UnconventionalComputingUWE/PhyChip/Bill of Materials and Pin Map.xls

Sheet: Bill of Materials
Phychip Breakout Board
Part | Value | Device | Package | Description | Manufacturer | MPN | OC_RS
C1 | 10uF | Capacitor POL, | 153CLV 0505 | POLARIZED CAPACITOR, European symbol
C2 | 10uF | Capacitor POL, | 153CLV 0505 | POLARIZED CAPACITOR, European symbol
C3 | 10uF | Capacitor POL, | 153CLV 0505 | POLARIZED CAPACITOR, European symbol
IC1 | DG406CWI | DG406CWI | SO28L | ANALOG MULTIPLEXER | MAXIM | DG406CWI | 797-9247
IC2 | DG406CWI | DG406CWI | SO28L | ANALOG MULTIPLEXER | MAXIM | DG406CWI | 797-9247
JP1 |  | Header | 1X08 | 8 Way 1 Row Socket. 2.54mm pitch |  |  | 681-2997
JP2 |  | Header | 1X08 | 8 Way 1 Row Socket. 2.54mm pitch |  |  | 681-2997
JP3 |  | Header | 1X10 | 10 Way 1 Row Socket. 2.54mm pitch
JP4 |  | Header | 1X10 | 10 Way 1 Row Socket. 2.54mm pitch
JP5 |  | Header | 1X08 | 4 Way 1 Row Header. 2.54mm pitch
JP6 |  | Header | 1X08 | 5 Way 1 Row Header. 2.54mm pitch
JP7 |  | Header | 1X08 | 6 Way 1 Row Header. 2.54mm pitch
JP8 |  | Header | 1X08 | 7 Way 1 Row Header. 2.54mm pitch
JP9 |  | Header | 1X08 | 8 Way 1 Row Header. 2.54mm pitch
JP10 |  | Header | 1X10 | 10 Way 1 Row Header. 2.54mm pitch
JP11 |  | Header | 2X18 | 36 Way 2 Row Straight Pin Header. 2.54mm pitch
U1 | LTC2440CGNPBF | LTC2440CGNPBF | SOP63P600X175-16N | ADC | Linear Technology | LTC2440CGN#PBF | 1651798
U2 | ADM660ARZ | ADM660ARZ | SOIC127P600X175-8N | CMOS Switched-Capacitor Voltage Converters | Analog Devices | ADM660ARZ | 1661070
Phychip MEA Plugin
Part | Value | Device | Package | Description
JP1 |  | Header | 1X08 | 4 Way 1 Row Header. 2.54mm pitch
JP2 |  | Header | 1X08 | 4 Way 1 Row Header. 2.54mm pitch
JP3 |  | Header | 1X10 | 10 Way 1 Row Header. 2.54mm pitch
JP4 |  | Header | 1X10 | 10 Way 1 Row Header. 2.54mm pitch
JP5 (optional) |  | Header | 1X10 | 10 Way 1 Row Header. 2.54mm pitch
JP6 (optional) |  | Header | 1X10 | 10 Way 1 Row Header. 2.54mm pitch

Sheet: Pin Map
Phychip Breakout Board |  |  |  | Phychip MEA Board
U1
Arduino |  | Phychip |  | Arduino | JP3 | JP4 | JP4 | JP5 | JP7
Pin | Function | Pin | Function | V+ | 1 | 1 | 1 | 1 | 1
D52 | sck | 13 | SCK | 2 | 2 | 2 | 2 | 2 | 2
D53 |  | 11 | ~CS | 3 | 3 | 3 | 3 | 3 | 3
D51 | mosi | 7 | SDI | 4 | 4 | 4 | 4 | 4 | 4
D50 | miso | 12 | SDO | 5 | 5 | 5 | 5 | 5 | 5
D49 |  | 15 | BUSY | 6 | 6 | 6 | 6 | 6 | 6
 |  |  |  | 7 | 7 | 7 | 7 | 7 | 7
IC1 |  |  |  | 8 | 8 | 8 | 8 | 8 | 8
Arduino |  | Phychip |  | 9 | 9 | 9 | 9 | 9 | 9
Pin | Function | Pin | Function | GND | 10 | 10 | 10 | 10 | 10
D29 |  | 17 | A0
D31 |  | 16 | A1
D33 |  | 15 | A2
D35 |  | 14 | A3 | IC1 & IC2 to MEA Pins |  |  |  | MUX control |  | Taken from DG406 Datasheet
D37 |  | 18 | EN
 |  |  |  | MUX Pin | MEA (X,Y) |  |  | A3 | A2 | A1 | A0 | En | On Switch
IC2 |  |  |  | S1 | 1,1 |  |  | X | X | X | X | 0 | None
Arduino |  | Phychip |  | S2 | 1,2 |  |  | 0 | 0 | 0 | 0 | 1 | 1
Pin | Function | Pin | Function | S3 | 3,1 |  |  | 0 | 0 | 0 | 1 | 1 | 2
D39 |  | 17 | A0 | S4 | 4,1 |  |  | 0 | 0 | 1 | 0 | 1 | 3
D41 |  | 16 | A1 | S5 | 2,1 |  |  | 0 | 0 | 1 | 1 | 1 | 4
D43 |  | 15 | A2 | S6 | 2,2 |  |  | 0 | 1 | 0 | 0 | 1 | 5
D45 |  | 14 | A3 | S7 | 3,2 |  |  | 0 | 1 | 0 | 1 | 1 | 6
D47 |  | 18 | EN | S8 | 4,2 |  |  | 0 | 1 | 1 | 0 | 1 | 7
 |  |  |  | S9 | 4,4 |  |  | 0 | 1 | 1 | 1 | 1 | 8
JP3 |  |  |  | S10 | 3,4 |  |  | 1 | 0 | 0 | 0 | 1 | 9
Arduino |  | Phychip |  | S11 | 2,4 |  |  | 1 | 0 | 0 | 1 | 1 | 10
Pin | Function | Pin | Function | S12 | 1,4 |  |  | 1 | 0 | 1 | 0 | 1 | 11
V+ | V+ | V+ | V+ | S13 | 4,3 |  |  | 1 | 0 | 1 | 1 | 1 | 12
A7 |  | 2 |  | S14 | 3,3 |  |  | 1 | 1 | 0 | 0 | 1 | 13
A6 |  | 3 |  | S15 | 2,3 |  |  | 1 | 1 | 0 | 1 | 1 | 14
A5 |  | 4 |  | S16 | 1,3 |  |  | 1 | 1 | 1 | 0 | 1 | 15
A4 |  | 5 |  |  |  |  |  | 1 | 1 | 1 | 1 | 1 | 16
A3 |  | 6
A2 |  | 7 |  |  |  | MEA Pin (X,Y) Reference
A1 |  | 8 |  | White Dot
A0 |  | 9 |  |  | 1,1 | 1,2 | 1,3 | 1,4
GND | GND | GND | GND |  | 2,1 | 2,2 | 2,3 | 2,4
 |  |  |  |  | 3,1 | 3,2 | 3,3 | 3,4
JP4 |  |  |  |  | 4,1 | 4,2 | 4,3 | 4,4
Arduino |  | Phychip
Pin | Function | Pin | Function
V+ | V+ | V+ | V+
D6 |  | 2
D7 |  | 3
D8 |  | 4
D9 |  | 5
D10 |  | 6
D11 |  | 7
D12 |  | 8
D13 |  | 9
GND | GND | GND | GND
