UnconventionalComputingUWE/PhyChip/PhychipDevelopmentBoard.brd

## EAGLE design PhychipDevelopmentBoard.brd (2017-04-05)

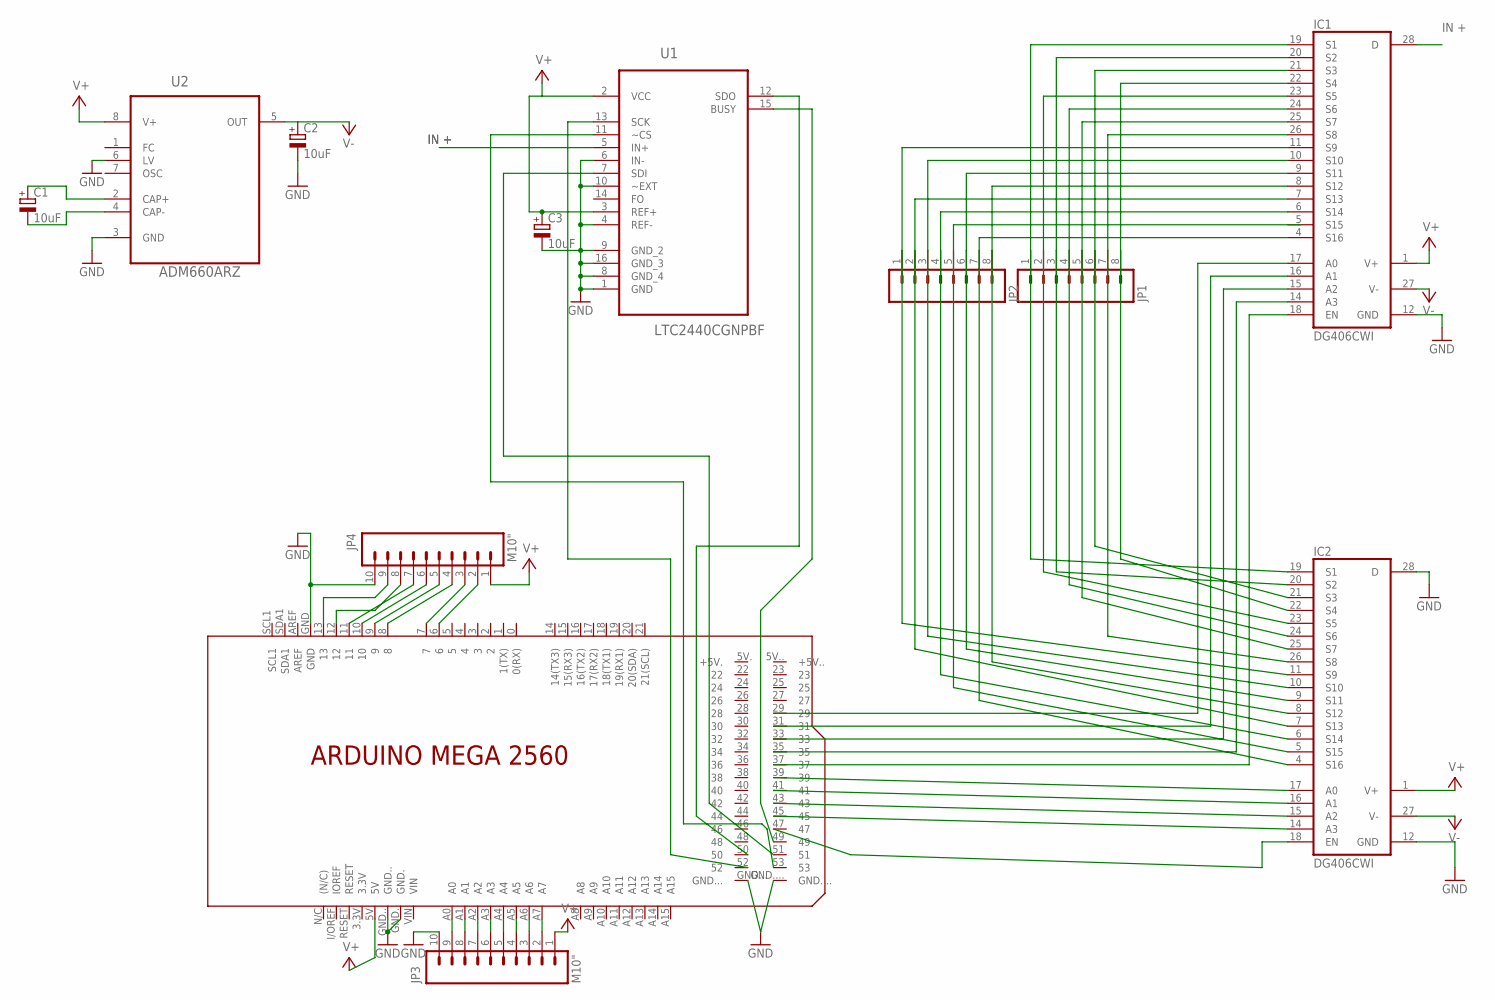
[picture p1: schematic PhychipDevelopmentBoard.sch]

Parts:
C1, C2, C3: 10uF; 153CLV-0505
IC1, IC2: DG406CWI; SO28L
JP1, JP2: M08; 1X08
JP3, JP4: M10"; 1X10
PCB1: ARDUINO_MEGA2560
U1: LTC2440CGNPBF; SOP63P600X175-16N
U2: ADM660ARZ; SOIC127P600X175-8N

Connections:
GND: C2.-, C3.-, IC1.12 (GND), IC2.12 (GND), IC2.28 (D), JP3.10, JP4.10, PCB1.GND, PCB1.GND., PCB1.GND.., PCB1.GND..., PCB1.GND...., U1.1 (GND), U1.4 (REF-), U1.6 (IN-), U1.8 (GND_4), U1.9 (GND_2), U1.10 (~EXT), U1.16 (GND_3), U2.3 (GND), U2.6 (LV)
IN+: IC1.28 (D), U1.5 (IN+)
unnamed: C1.+, U2.2 (CAP+)
unnamed: C1.-, U2.4 (CAP-)
unnamed: PCB1.52, U1.13 (SCK)
unnamed: PCB1.50, U1.12 (SDO)
unnamed: PCB1.51, U1.7 (SDI)
unnamed: PCB1.49, U1.15 (BUSY)
unnamed: PCB1.53, U1.11 (~CS)
unnamed: IC2.18 (EN), PCB1.47
unnamed: IC2.14 (A3), PCB1.45
unnamed: IC2.15 (A2), PCB1.43
unnamed: IC2.16 (A1), PCB1.41
unnamed: IC2.17 (A0), PCB1.39
unnamed: IC1.18 (EN), PCB1.37
unnamed: IC1.14 (A3), PCB1.35
unnamed: IC1.15 (A2), PCB1.33
unnamed: IC1.16 (A1), PCB1.31
unnamed: IC1.17 (A0), PCB1.29
unnamed: IC1.19 (S1), IC2.19 (S1), JP1.1
unnamed: IC1.20 (S2), IC2.20 (S2), JP1.3
unnamed: IC1.21 (S3), IC2.21 (S3), JP1.6
unnamed: IC1.22 (S4), IC2.22 (S4), JP1.8
unnamed: IC1.23 (S5), IC2.23 (S5), JP1.2
unnamed: IC1.24 (S6), IC2.24 (S6), JP1.4
unnamed: IC1.25 (S7), IC2.25 (S7), JP1.5
unnamed: IC1.26 (S8), IC2.26 (S8), JP1.7
unnamed: IC1.11 (S9), IC2.11 (S9), JP2.1
unnamed: IC1.10 (S10), IC2.10 (S10), JP2.3
unnamed: IC1.9 (S11), IC2.9 (S11), JP2.6
unnamed: IC1.8 (S12), IC2.8 (S12), JP2.8
unnamed: JP3.9, PCB1.A0
unnamed: JP3.8, PCB1.A1
unnamed: JP3.7, PCB1.A2
unnamed: JP3.6, PCB1.A3
unnamed: JP3.5, PCB1.A4
unnamed: JP3.4, PCB1.A5
unnamed: JP3.3, PCB1.A6
unnamed: JP3.2, PCB1.A7
unnamed: IC1.7 (S13), IC2.7 (S13), JP2.2
unnamed: JP4.9, PCB1.13
unnamed: IC1.6 (S14), IC2.6 (S14), JP2.4
unnamed: IC2.5 (S15), JP2.5
unnamed: IC1.4 (S16), IC2.4 (S16), JP2.7
unnamed: JP4.8, PCB1.12
unnamed: JP4.7, PCB1.11
unnamed: JP4.6, PCB1.10
unnamed: JP4.5, PCB1.9
unnamed: JP4.4, PCB1.8
unnamed: JP4.3, PCB1.7
unnamed: JP4.2, PCB1.6
V+: C3.+, IC1.1 (V+), IC2.1 (V+), JP3.1, JP4.1, PCB1.5V, U1.2 (VCC), U1.3 (REF+), U2.8 (V+)
V-: C2.+, IC1.27 (V-), IC2.27 (V-), U2.5 (OUT)

Notes on the sheet:
IN +

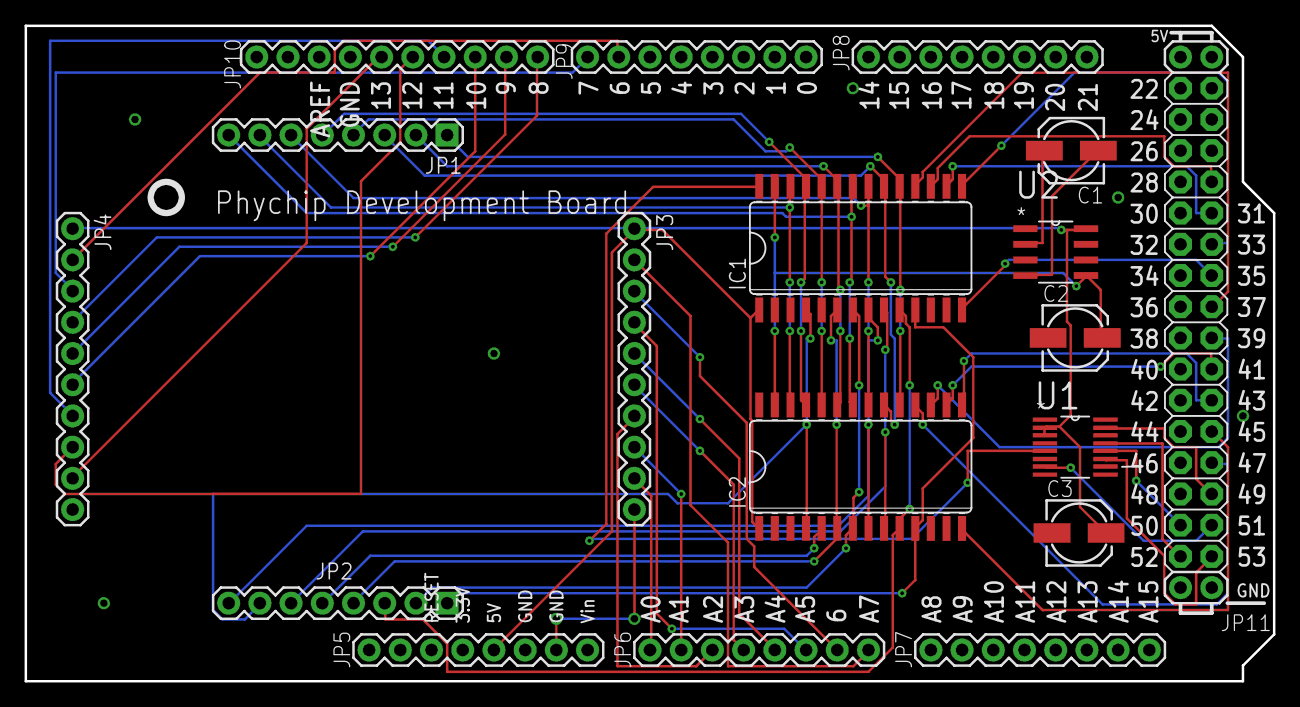
[picture p2: board PhychipDevelopmentBoard.brd from above]

Board: 2 copper layers, 101.6 x 53.3 mm, 12 parts (0 on the bottom side), 53 nets.
