UnconventionalComputingUWE/PhyChip/phyplugin.brd

## EAGLE design phyplugin.brd (2017-04-04)

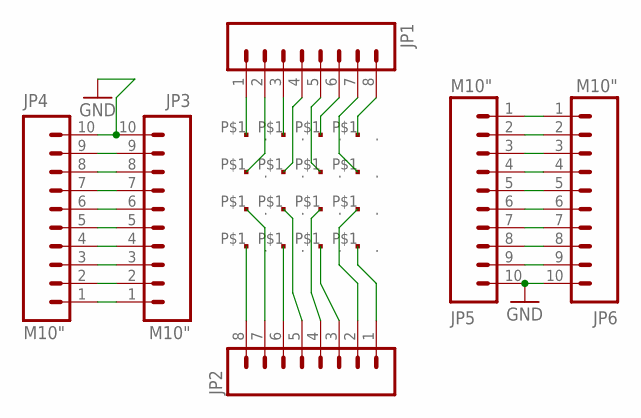
[picture p3: schematic phyplugin.sch]

Parts:
JP1, JP2: M08; 1X08
JP3, JP4, JP5, JP6: M10"; 1X10
U$1, U$2, U$3, U$4, U$5, U$6, U$7, U$8, U$9, U$10, U$11, U$12, U$13, U$14, U$15, U$16: MEAPAD; MEAPAD1MM

Connections:
GND: JP3.10, JP4.10, JP5.10, JP6.10
unnamed: JP1.4, U$6.P$1
unnamed: JP1.5, U$7.P$1
unnamed: JP1.3, U$2.P$1
unnamed: JP1.6, U$3.P$1
unnamed: JP1.2, U$5.P$1
unnamed: JP1.1, U$1.P$1
unnamed: JP1.7, U$8.P$1
unnamed: JP1.8, U$4.P$1
unnamed: JP2.5, U$10.P$1
unnamed: JP2.4, U$11.P$1
unnamed: JP2.6, U$14.P$1
unnamed: JP2.3, U$15.P$1
unnamed: JP2.7, U$9.P$1
unnamed: JP2.2, U$12.P$1
unnamed: JP2.1, U$16.P$1
unnamed: JP2.8, U$13.P$1
unnamed: JP5.1, JP6.1
unnamed: JP3.1, JP4.1
unnamed: JP3.2, JP4.2
unnamed: JP3.3, JP4.3
unnamed: JP3.4, JP4.4
unnamed: JP3.5, JP4.5
unnamed: JP3.6, JP4.6
unnamed: JP3.7, JP4.7
unnamed: JP3.8, JP4.8
unnamed: JP3.9, JP4.9
unnamed: JP5.2, JP6.2
unnamed: JP5.3, JP6.3
unnamed: JP5.4, JP6.4
unnamed: JP5.5, JP6.5
unnamed: JP5.6, JP6.6
unnamed: JP5.7, JP6.7
unnamed: JP5.8, JP6.8
unnamed: JP5.9, JP6.9

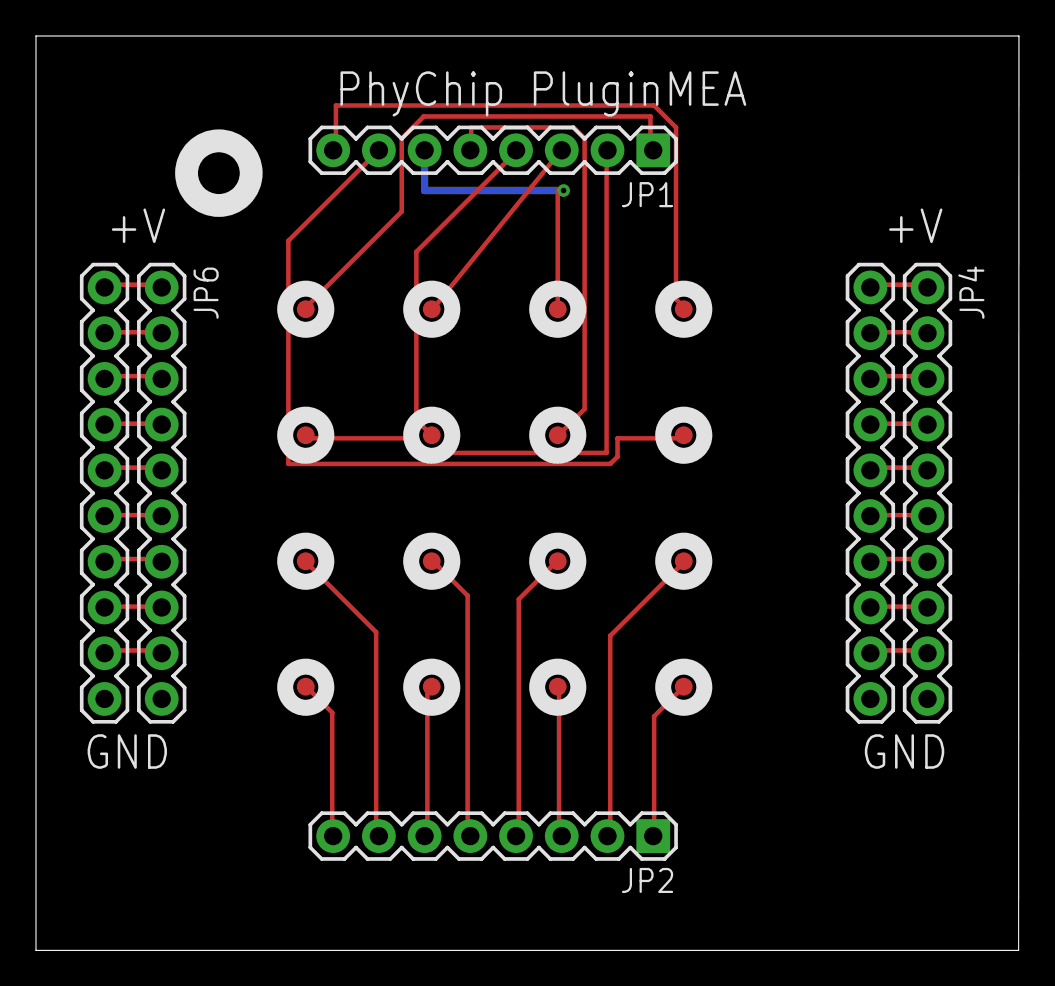
[picture p4: board phyplugin.brd from above]

Board: 2 copper layers, 54.6 x 50.8 mm, 22 parts (0 on the bottom side), 35 nets.
