UnconventionalComputingUWE/PhyChip/(commit log)

2017-04-04 Rename phychipDevelopmentBoardV0.9.brd to Phychip Development Board.brd
    [Phychip Development Board.brd]
2017-04-04 Rename phychipDevelopmentBoardV0.9.sch to Phychip Development Board.sch
    [Phychip Development Board.sch]
2017-04-04 Create Arduino Pin map
